Ethereal-Space-Inc/esi-c3-hardware/README.md

This company is crazy but so am I... a match made in heaven.
- jt
