Ethereal-Space-Inc/esi-c3-hardware/esi-c3-hardware/esi-c3-hardware.pdf

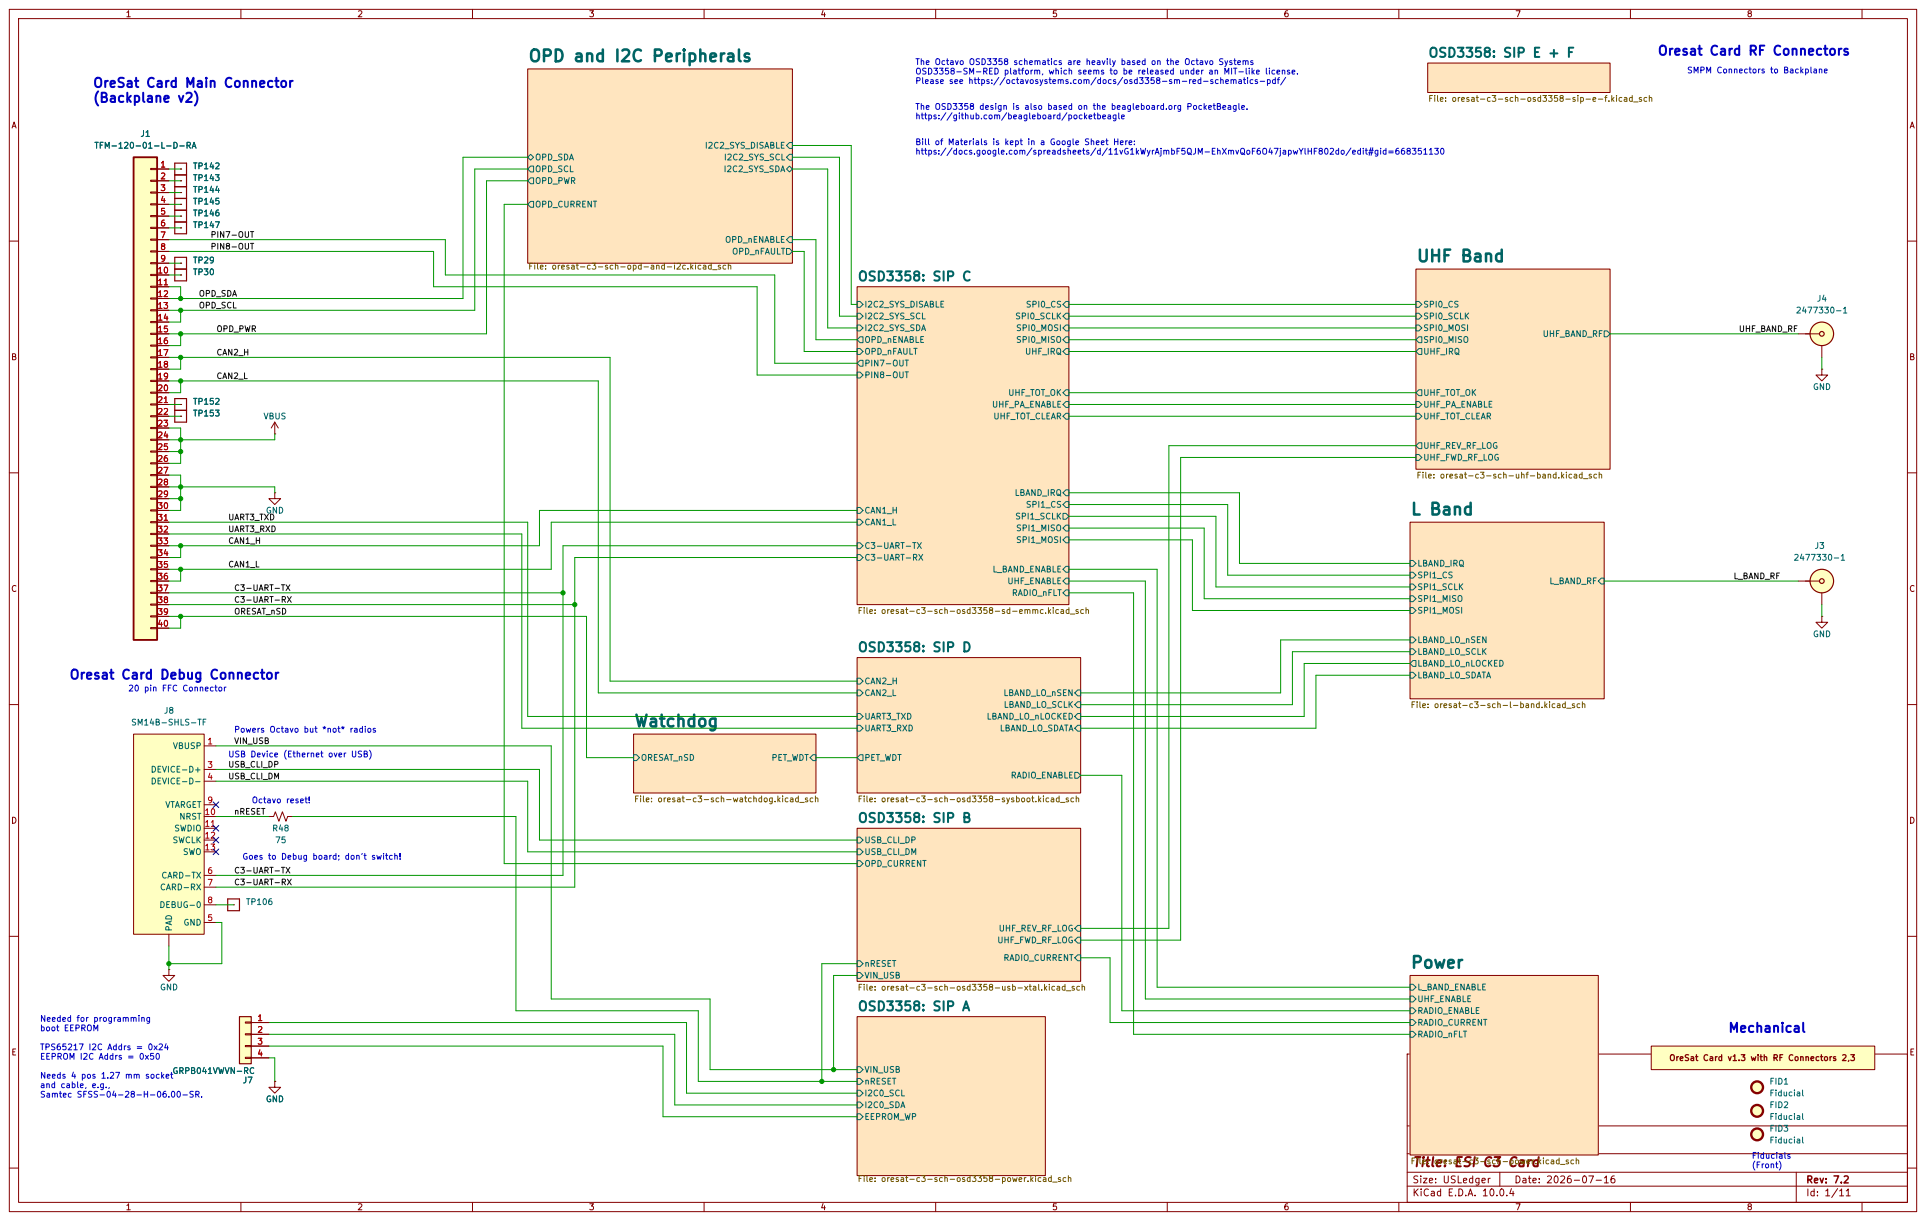
[picture p1: page 1]

Oresat Card RF Connectors

The Octavo OSD3358 schematics are heavily based on the Octavo Systems OSD3358-SM-RED platform, which seems to be released under an MIT-like license. Please see https://octavosystems.com/docs/osd3358-sm-red-schematics-pdf/

SMPM Connectors to Backplane

OreSat Card Main Connector
(Backplane v2)
CAN2_L C3-UART-RX Goes to Debug board; don't switch!

File: oresat-c3-sch-osd3358-sip-e-f.kicad_sch CAN2_H

The OSD3358 design is also based on the beagleboard.org PocketBeagle.
https://github.com/beagleboard/pocketbeagle

Bill of Materials is kept in a Google Sheet Here: https://docs.google.com/spreadsheets/d/11vG1kWyrAjmbF5QJM-EhXmvQoF6O47japwYlHF802do/edit#gid=668351130

File: oresat-c3-sch-uhf-band.kicad_sch OPD_nFAULT

33 33 CAN1_H
34 34

C3-UART-TX ORESAT_nSD 38 38

39 39
40 40

Octavo reset! Oresat Card Debug Connector

USB Device (Ethernet over USB) Powers Octavo but *not* radios

File: oresat-c3-sch-osd3358-sysboot.kicad_sch
nRESET OSD3358: SIP B
VIN_USB USB_CLI_DP

C3-UART-RX C3-UART-TX

Ethereal Space Inc. X PSAS | Mechanical Fiducials

TPS65217 I2C Addrs = 0x24
EEPROM I2C Addrs = 0x50 Needs 4 pos 1.27 mm socket and cable, e.g., Samtec SFSS-04-28-H-06.00-SR.

Fiducial OreSat Card v1.3 with RF Connectors 2,3

Sheet: / File: esi-c3-hardware.kicad_sch | FID3 Fiducial

Size: USLedger | Rev: 7.2
KiCad E.D.A. 10.0.4 | Id: 1/11

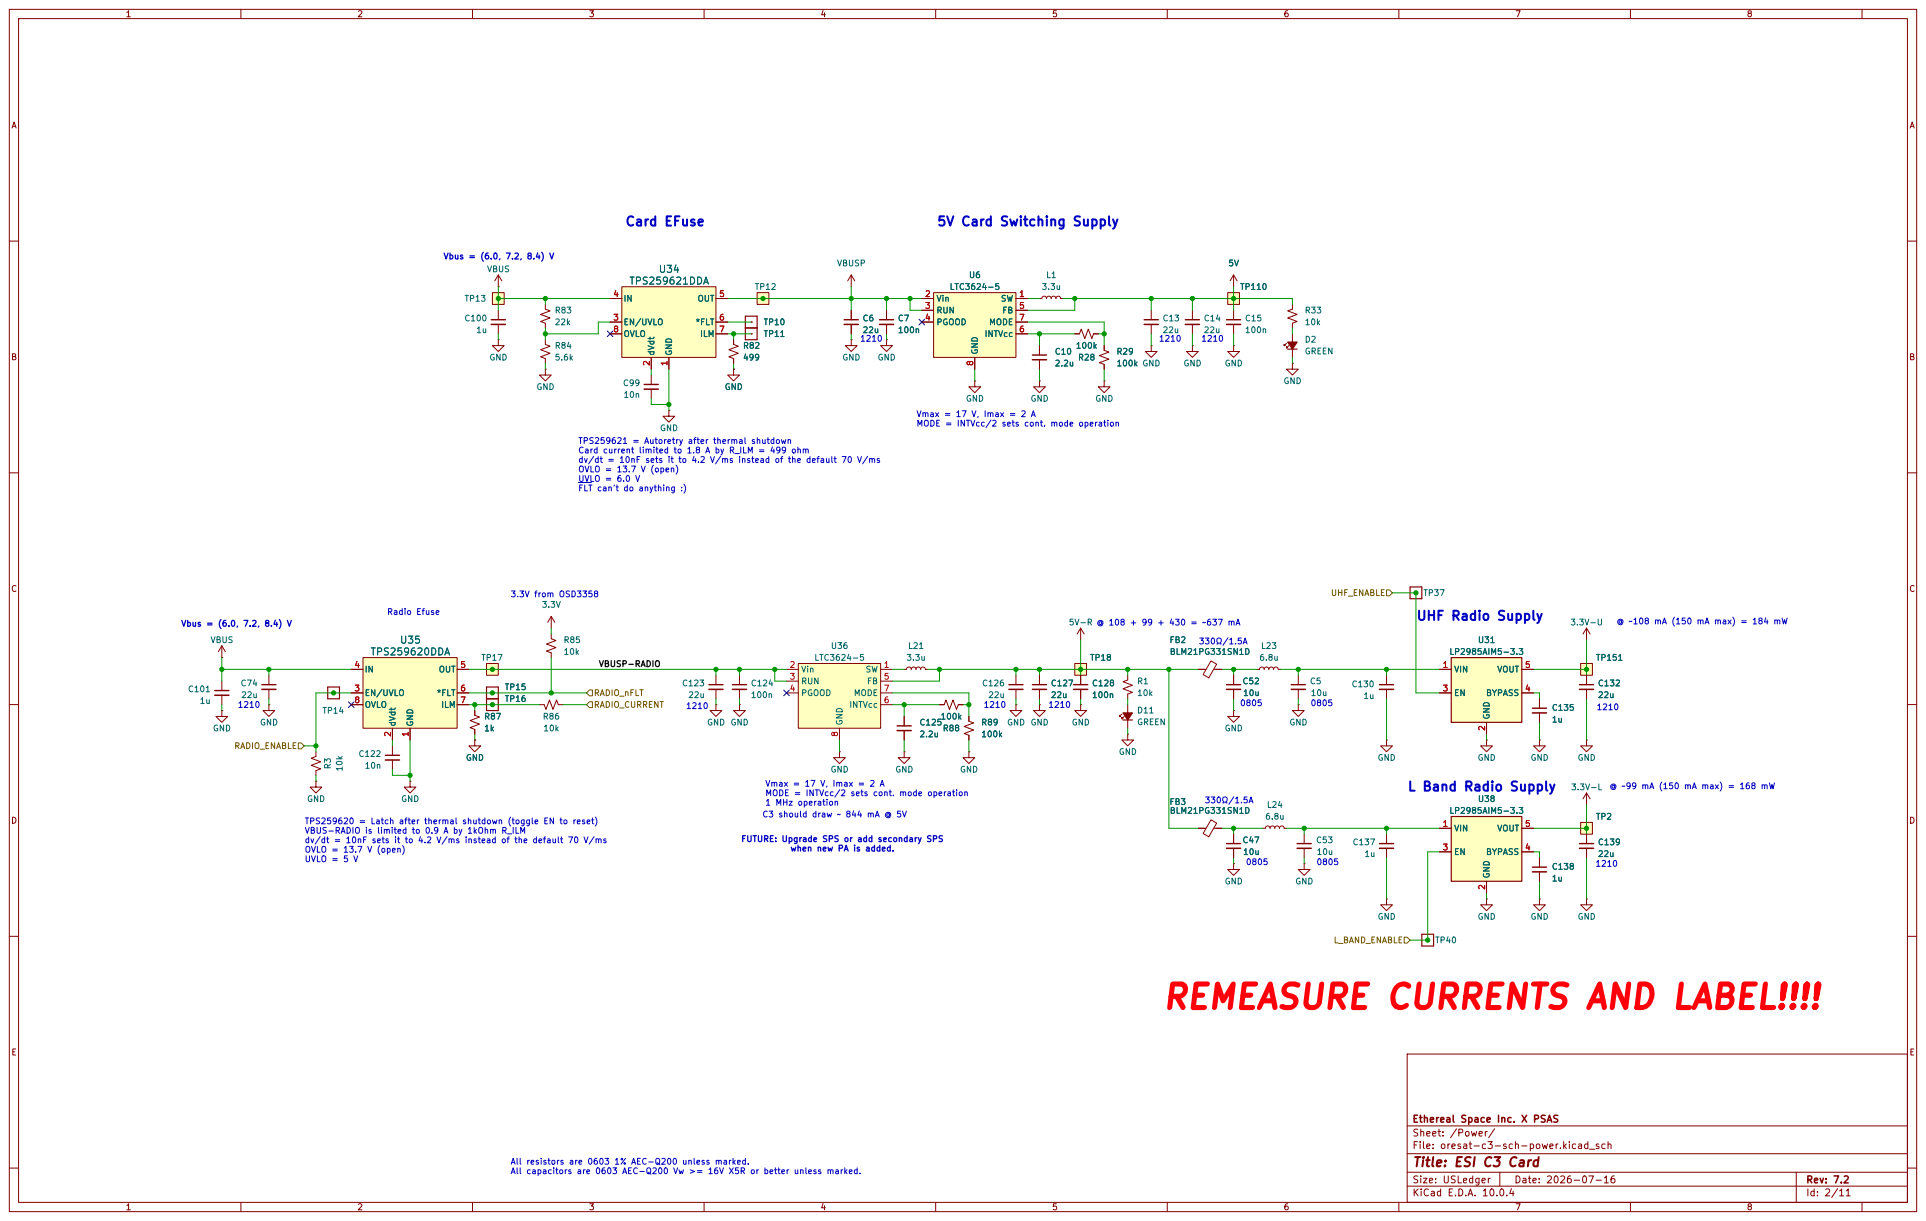
[picture p2: page 2]

TPS259621 = Autoretry after thermal shutdown Card current limited to 1.8 A by R_ILM = 499 ohm

dv/dt = 10nF sets it to 4.2 V/ms instead of the default 70 V/ms OVLO = 13.7 V (open) UVLO = 6.0 V

Vmax = 17 V, Imax = 2 A MODE = INTVcc/2 sets cont. mode operation 1 MHz operation

TPS259620 = Latch after thermal shutdown (toggle EN to reset) VBUS-RADIO is limited to 0.9 A by 1kOhm R_ILM

FUTURE: Upgrade SPS or add secondary SPS when new PA is added. C3 should draw ~ 844 mA @ 5V

Ethereal Space Inc. X PSAS
Sheet: /Power/
File: oresat-c3-sch-power.kicad_sch

All resistors are 0603 1% AEC-Q200 unless marked. All capacitors are 0603 AEC-Q200 Vw >= 16V X5R or better unless marked.

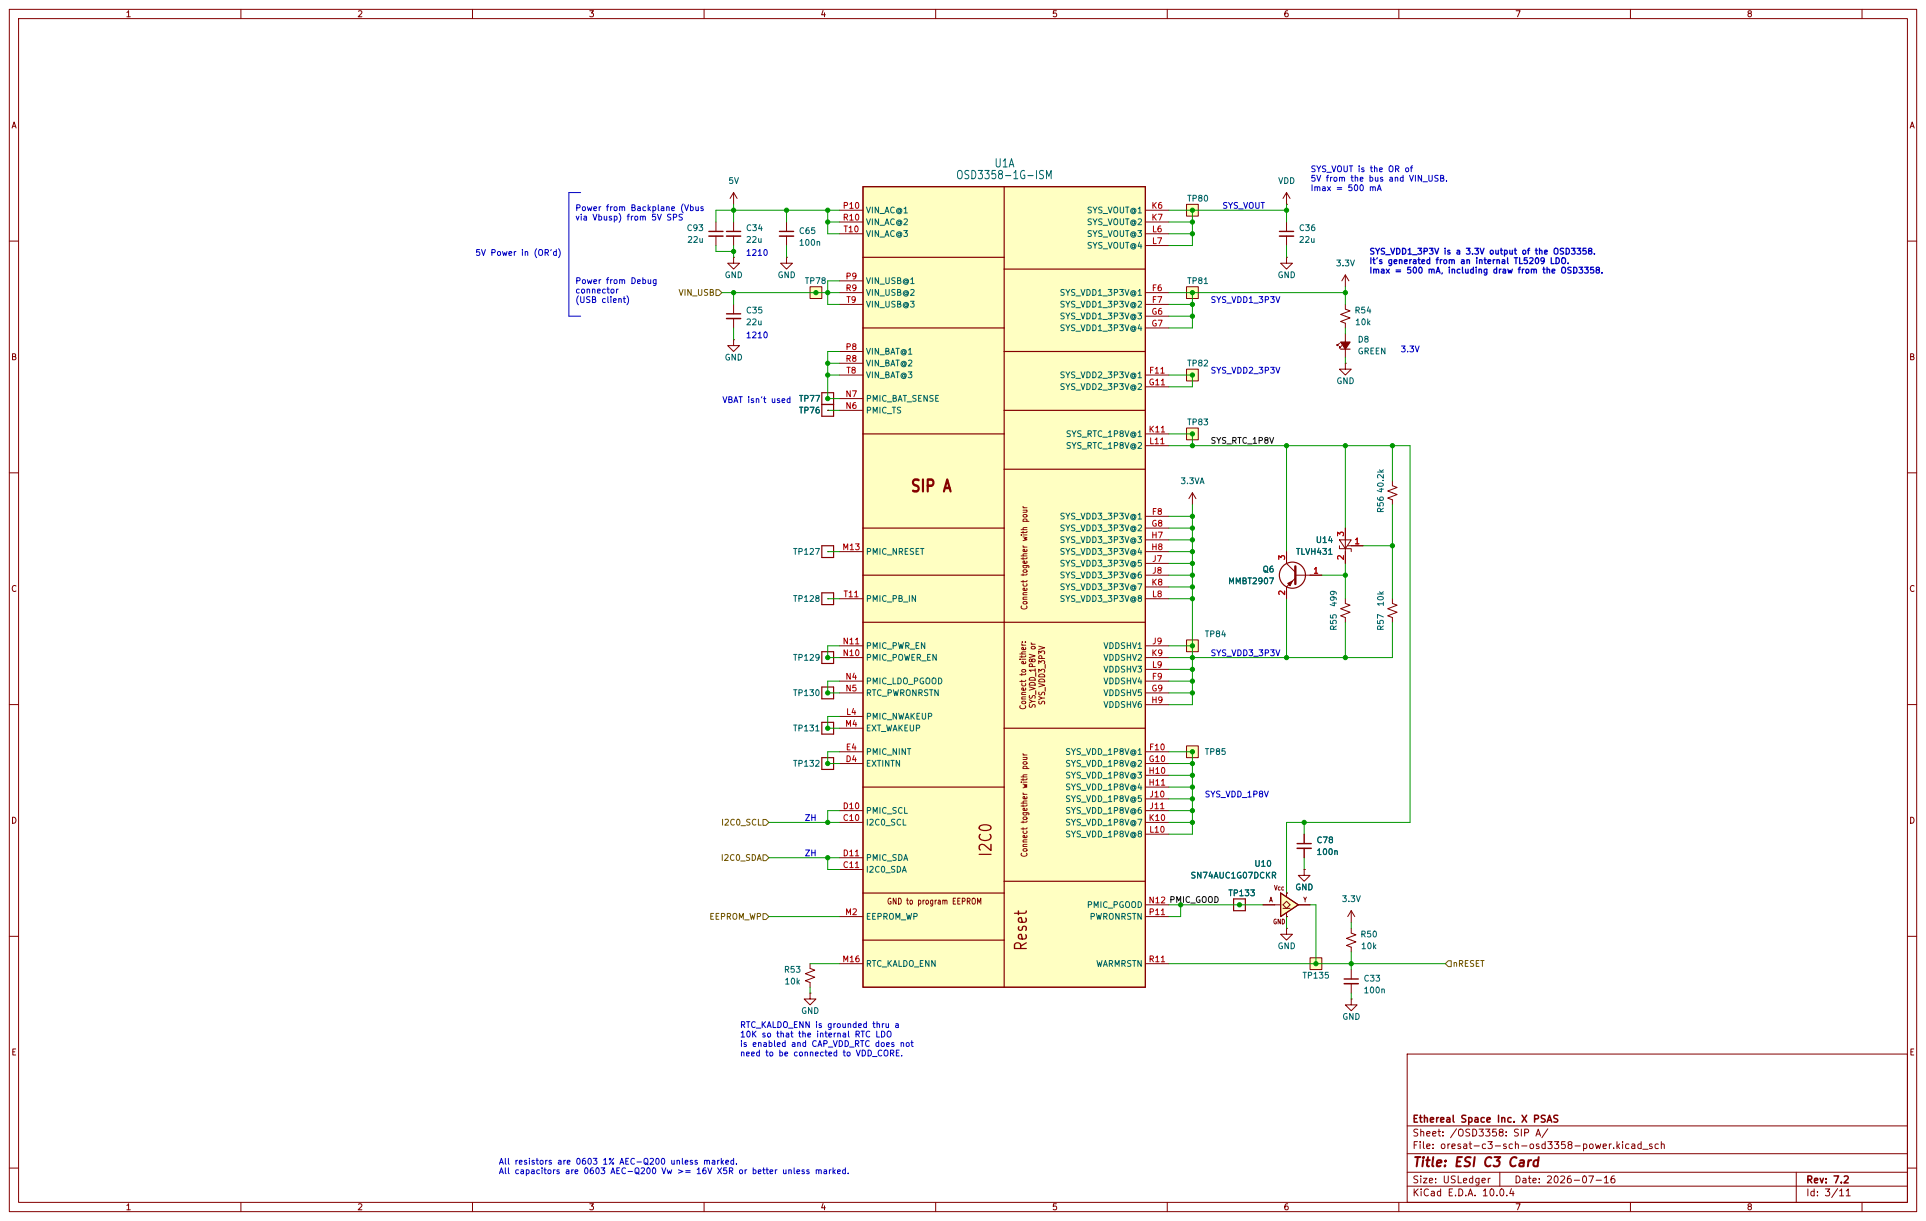
[picture p3: page 3]

VBAT isn't used Power from Backplane (Vbus
via Vbusp) from 5V SPS

SYS_VDD1_3P3V is a 3.3V output of the OSD3358.
It's generated from an internal TL5209 LDO.

Imax = 500 mA, including draw from the OSD3358. 3.3V SYS_VDD1_3P3V ZH

RTC_KALDO_ENN is grounded thru a 10K so that the internal RTC LDO

is enabled and CAP_VDD_RTC does not need to be connected to VDD_CORE. All resistors are 0603 1% AEC-Q200 unless marked. All capacitors are 0603 AEC-Q200 Vw >= 16V X5R or better unless marked.

Ethereal Space Inc. X PSAS
Sheet: /OSD3358: SIP A/
File: oresat-c3-sch-osd3358-power.kicad_sch

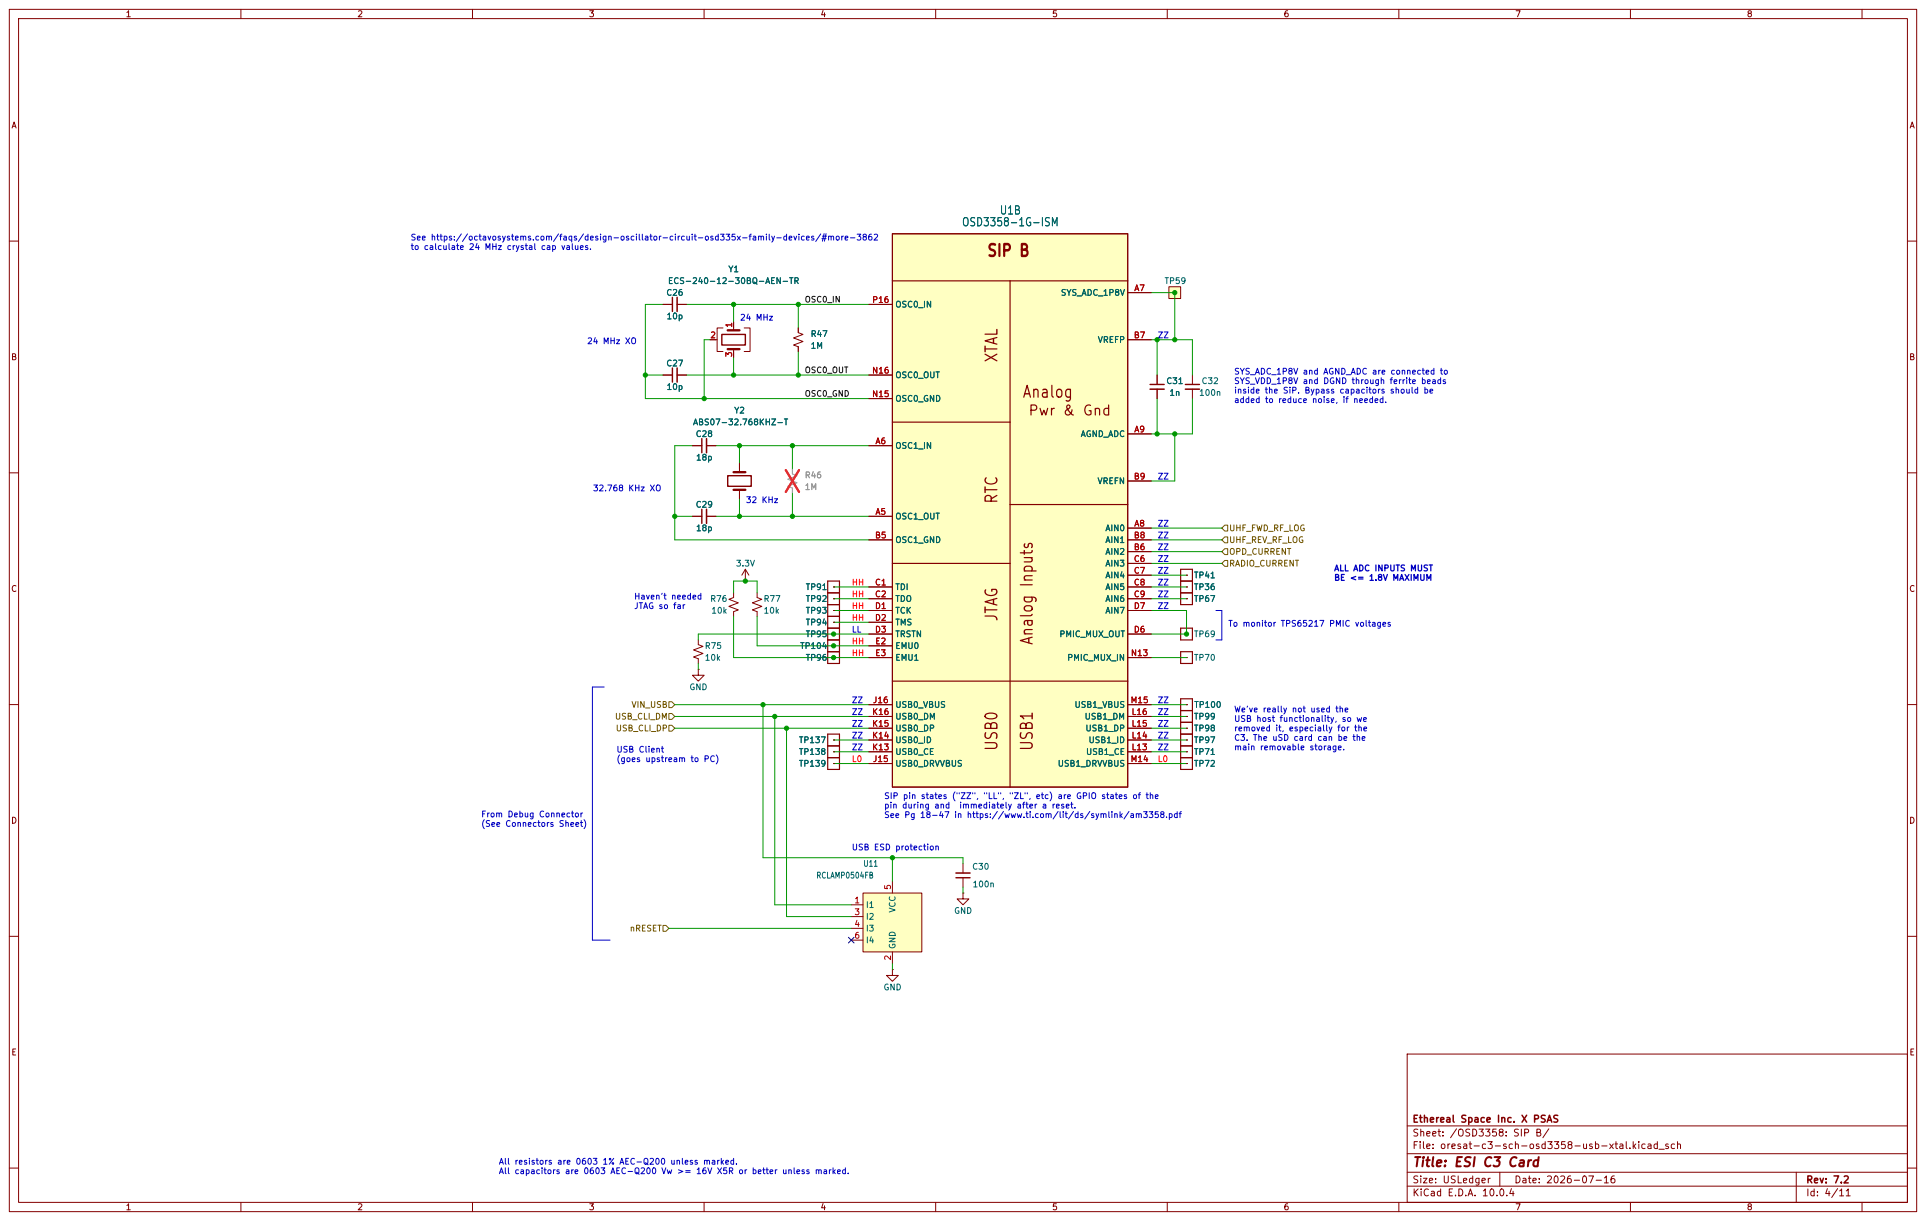
[picture p4: page 4]

SIP B XTAL RTC JTAG USB0

See https://octavosystems.com/faqs/design-oscillator-circuit-osd335x-family-devices/#more-3862

inside the SiP. Bypass capacitors should be added to reduce noise, if needed. 32.768 KHz XO

Pwr & Gnd

SIP pin states ("ZZ", "LL", "ZL", etc) are GPIO states of the pin during and immediately after a reset. See Pg 18-47 in https://www.ti.com/lit/ds/symlink/am3358.pdf ZZ Haven't needed
RADIO_CURRENT VIN_USB

TP95 | HH | EMU0 E2

removed it, especially for the C3. The uSD card can be the main removable storage. ZZ

Ethereal Space Inc. X PSAS
Sheet: /OSD3358: SIP B/
File: oresat-c3-sch-osd3358-usb-xtal.kicad_sch

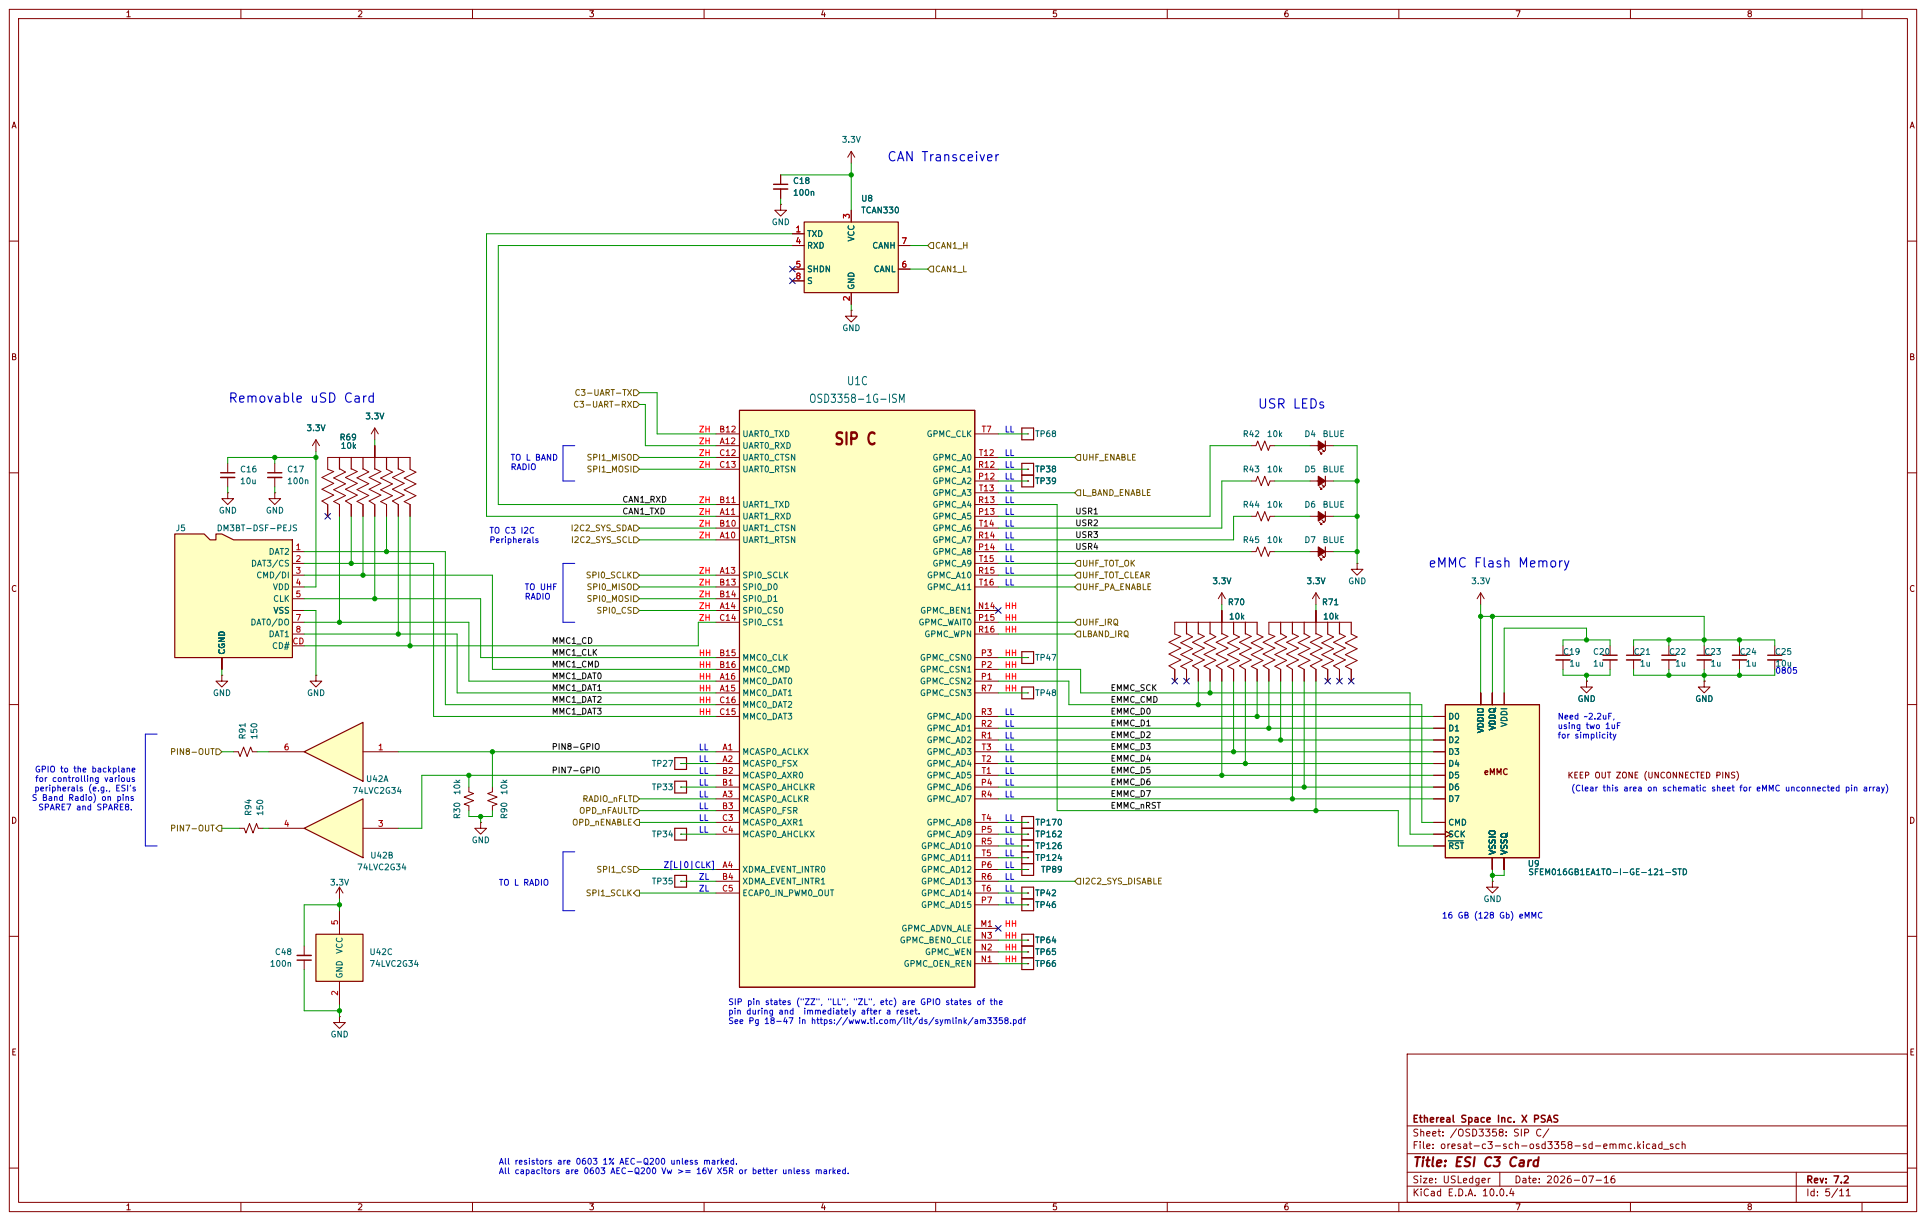
[picture p5: page 5]

ZH TO UHF RADIO

SPI0_D1 B14 MMC0_CLK B15 MMC0_CMD B16 MCASP0_AXR1 C3 MCASP0_AHCLKX C4 SPI0_CS0 A14 MMC0_DAT1 A15 MMC0_DAT0 A16 MCASP0_AHCLKR B1 MCASP0_AXR0 B2 MCASP0_FSR B3 | HH

VSS DAT0/DO 7 DAT1 8 CD# CD CGND
10k GND

LL

LL | | LL | EMMC_D4 | | | | for simplicity LL

EMMC_D3

ZL GPIO to the backplane

ECAP0_IN_PWM0_OUT C5 | | EMMC_D6

LL | EMMC_D7

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

Ethereal Space Inc. X PSAS
Sheet: /OSD3358: SIP C/
File: oresat-c3-sch-osd3358-sd-emmc.kicad_sch

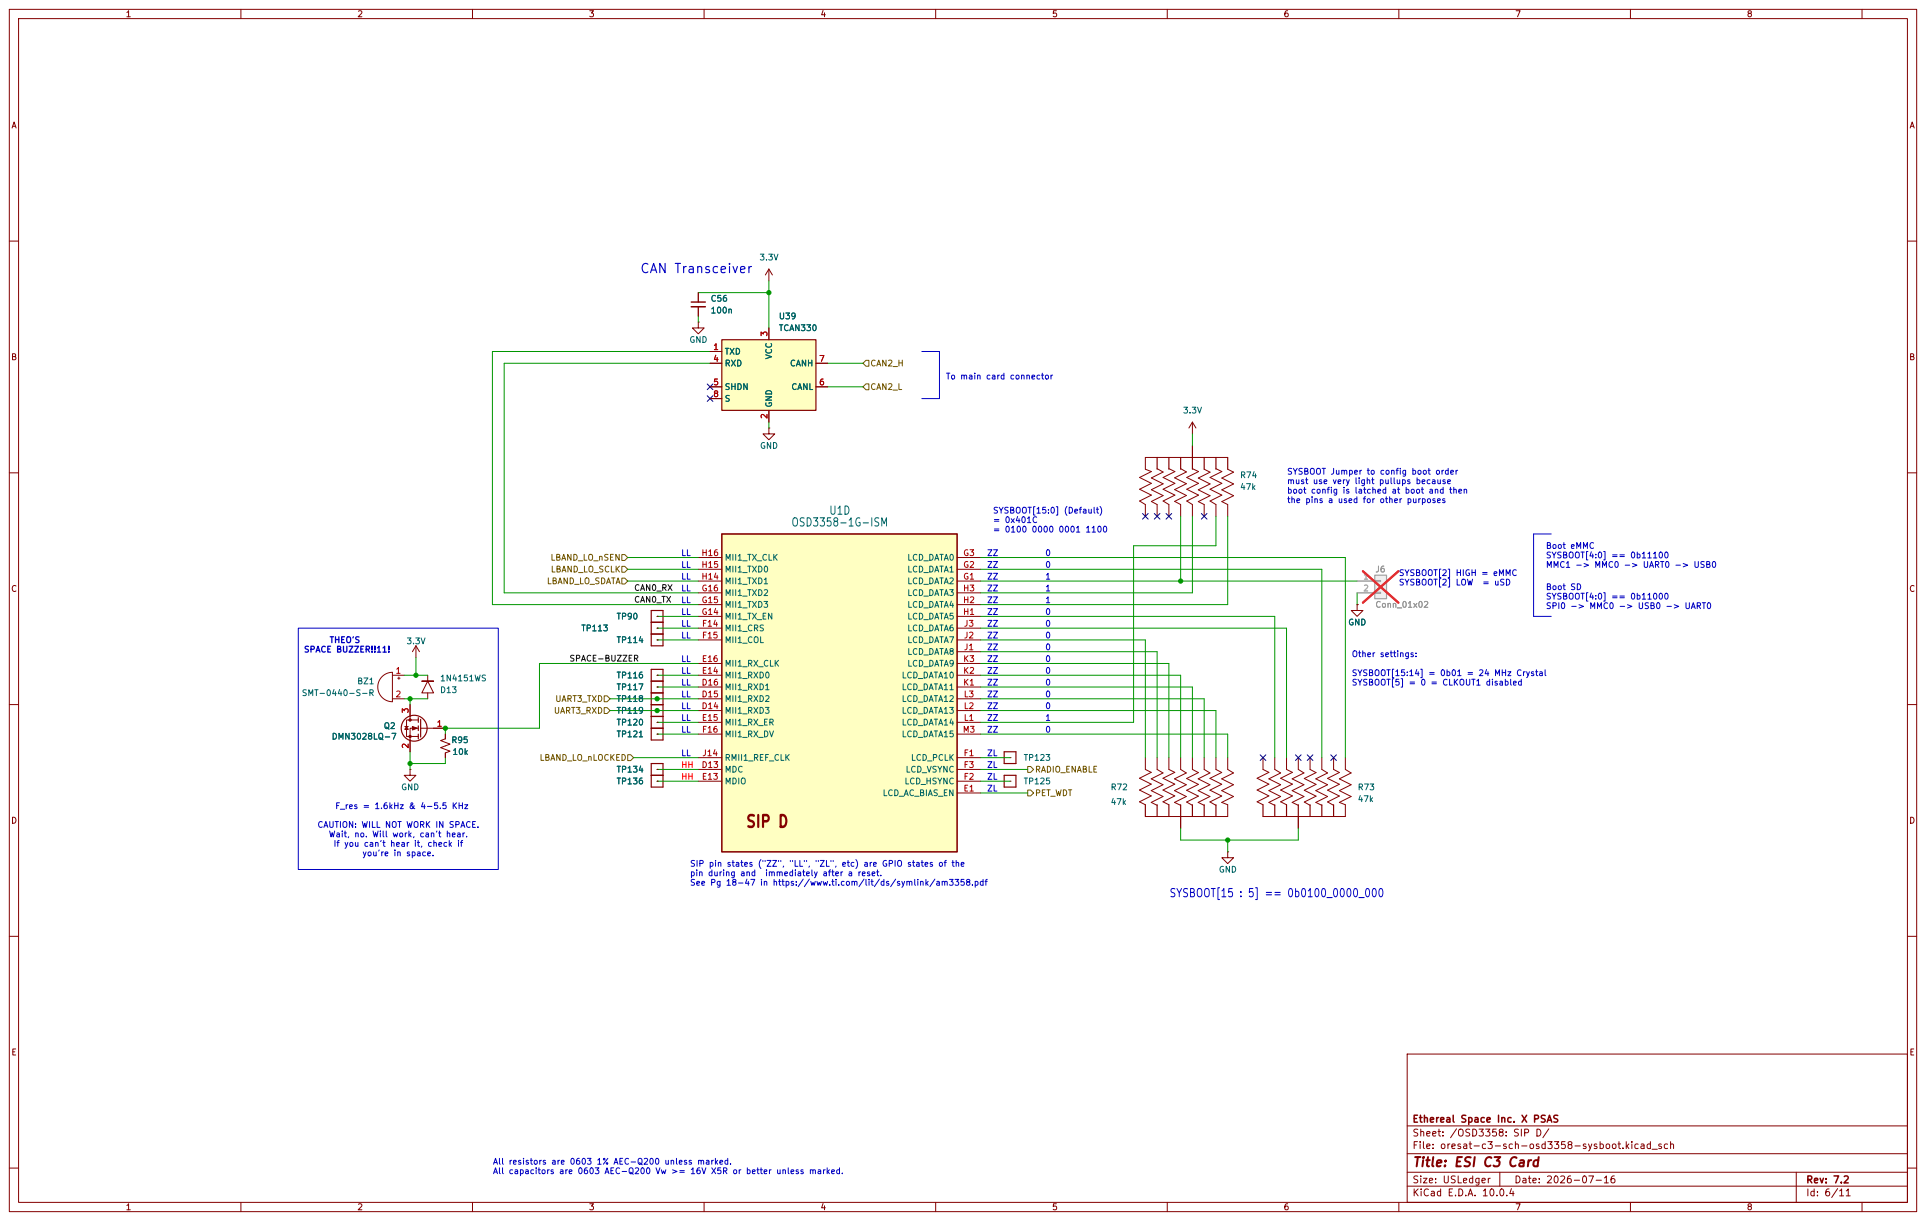
[picture p6: page 6]

47k GND

SYSBOOT Jumper to config boot order must use very light pullups because boot config is latched at boot and then

the pins a used for other purposes Other settings:

ZZ 0 | SYSBOOT[5] = 0 = CLKOUT1 disabled 0

LLSIP pin states ("ZZ", "LL", "ZL", etc) are GPIO states of the pin during and immediately after a reset. See Pg 18-47 in https://www.ti.com/lit/ds/symlink/am3358.pdf All resistors are 0603 1% AEC-Q200 unless marked. All capacitors are 0603 AEC-Q200 Vw >= 16V X5R or better unless marked. HH

ZZ 0
ZZ

F_res = 1.6kHz & 4-5.5 KHz CAUTION: WILL NOT WORK IN SPACE. Wait, no. Will work, can't hear.

Ethereal Space Inc. X PSAS
Sheet: /OSD3358: SIP D/
File: oresat-c3-sch-osd3358-sysboot.kicad_sch

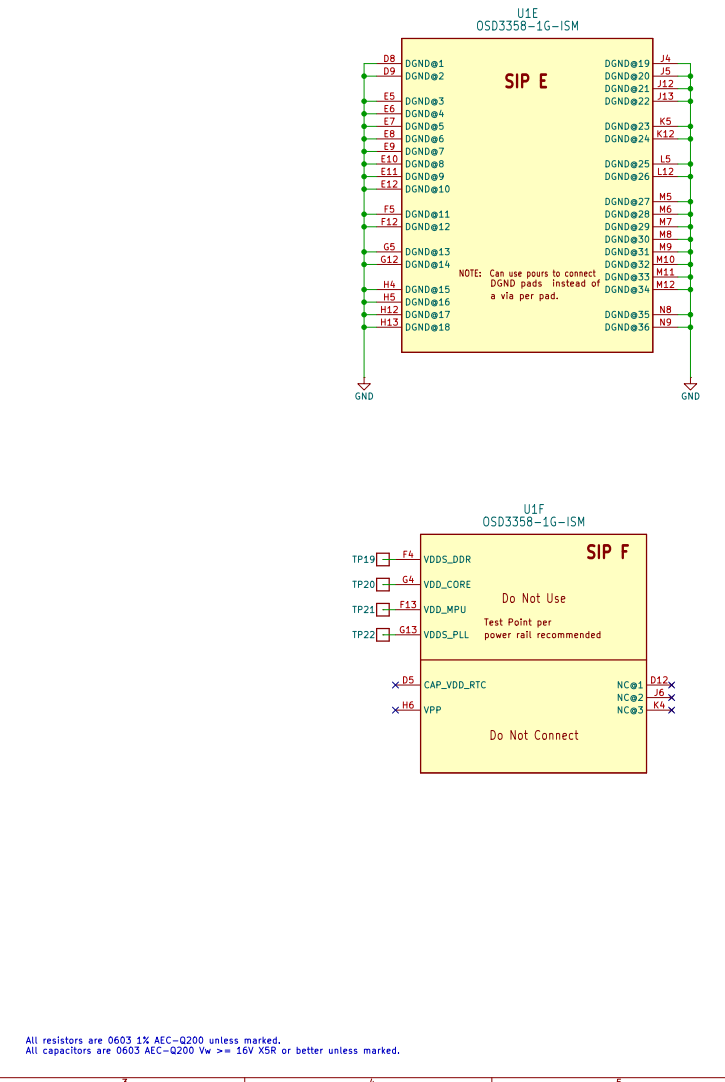
[picture p7: page 7]

Test Point per power rail recommended Do Not Use

Ethereal Space Inc. X PSAS
Sheet: /OSD3358: SIP E + F/
File: oresat-c3-sch-osd3358-sip-e-f.kicad_sch

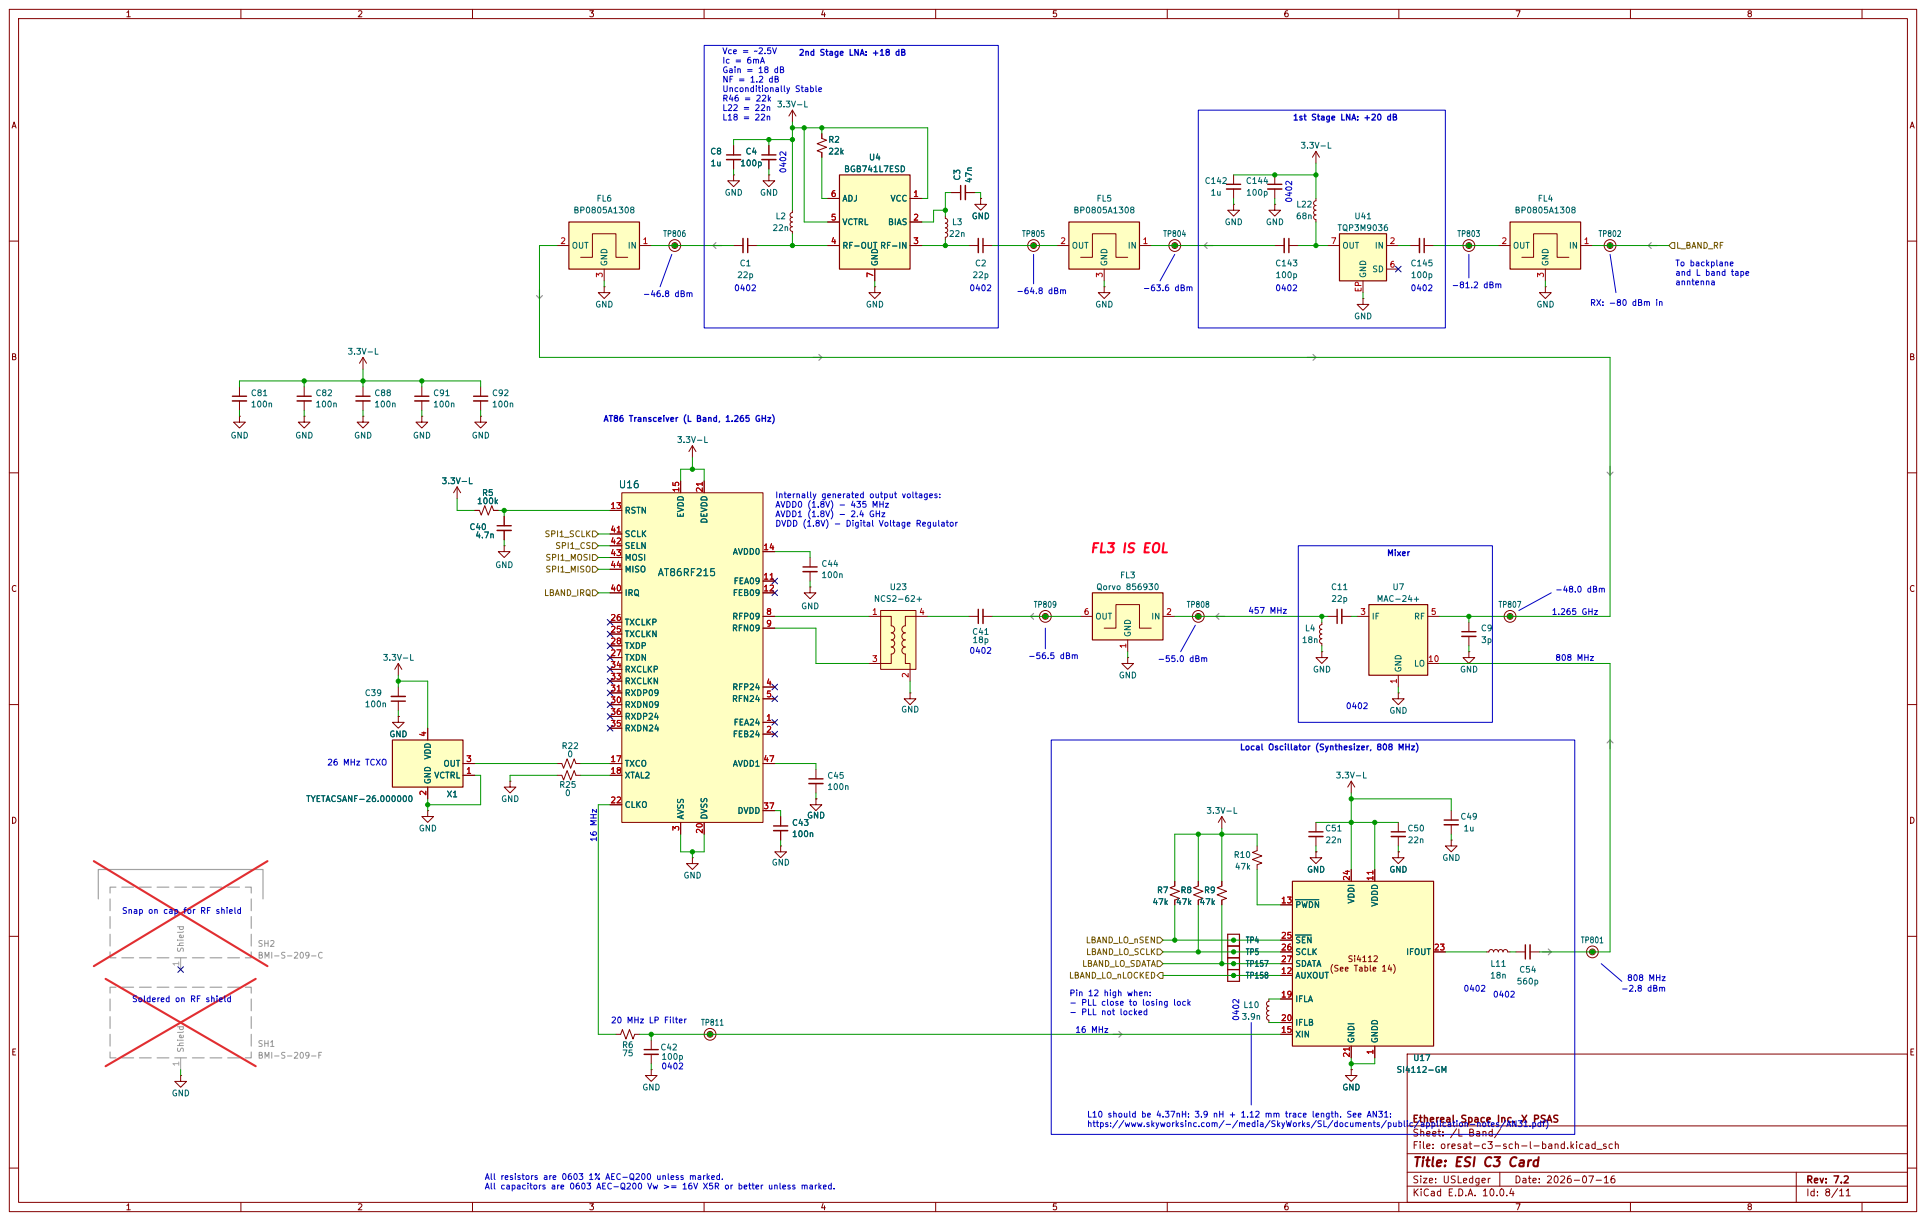
[picture p8: page 8]

Vce = ~2.5V
Ic = 6mA Gain = 18 dB NF = 1.2 dB Unconditionally Stable R46 = 22k
FL5 BP0805A1308 GND GND

To backplane and L band tape anntenna

Local Oscillator (Synthesizer, 808 MHz) L10 should be 4.37nH: 3.9 nH + 1.12 mm trace length. See AN31: https://www.skyworksinc.com/-/media/SkyWorks/SL/documents/public/application-notes/AN31.pdf) 20 MHz LP Filter
TXCO 17

Ethereal Space Inc. X PSAS
Sheet: /L Band/
File: oresat-c3-sch-l-band.kicad_sch

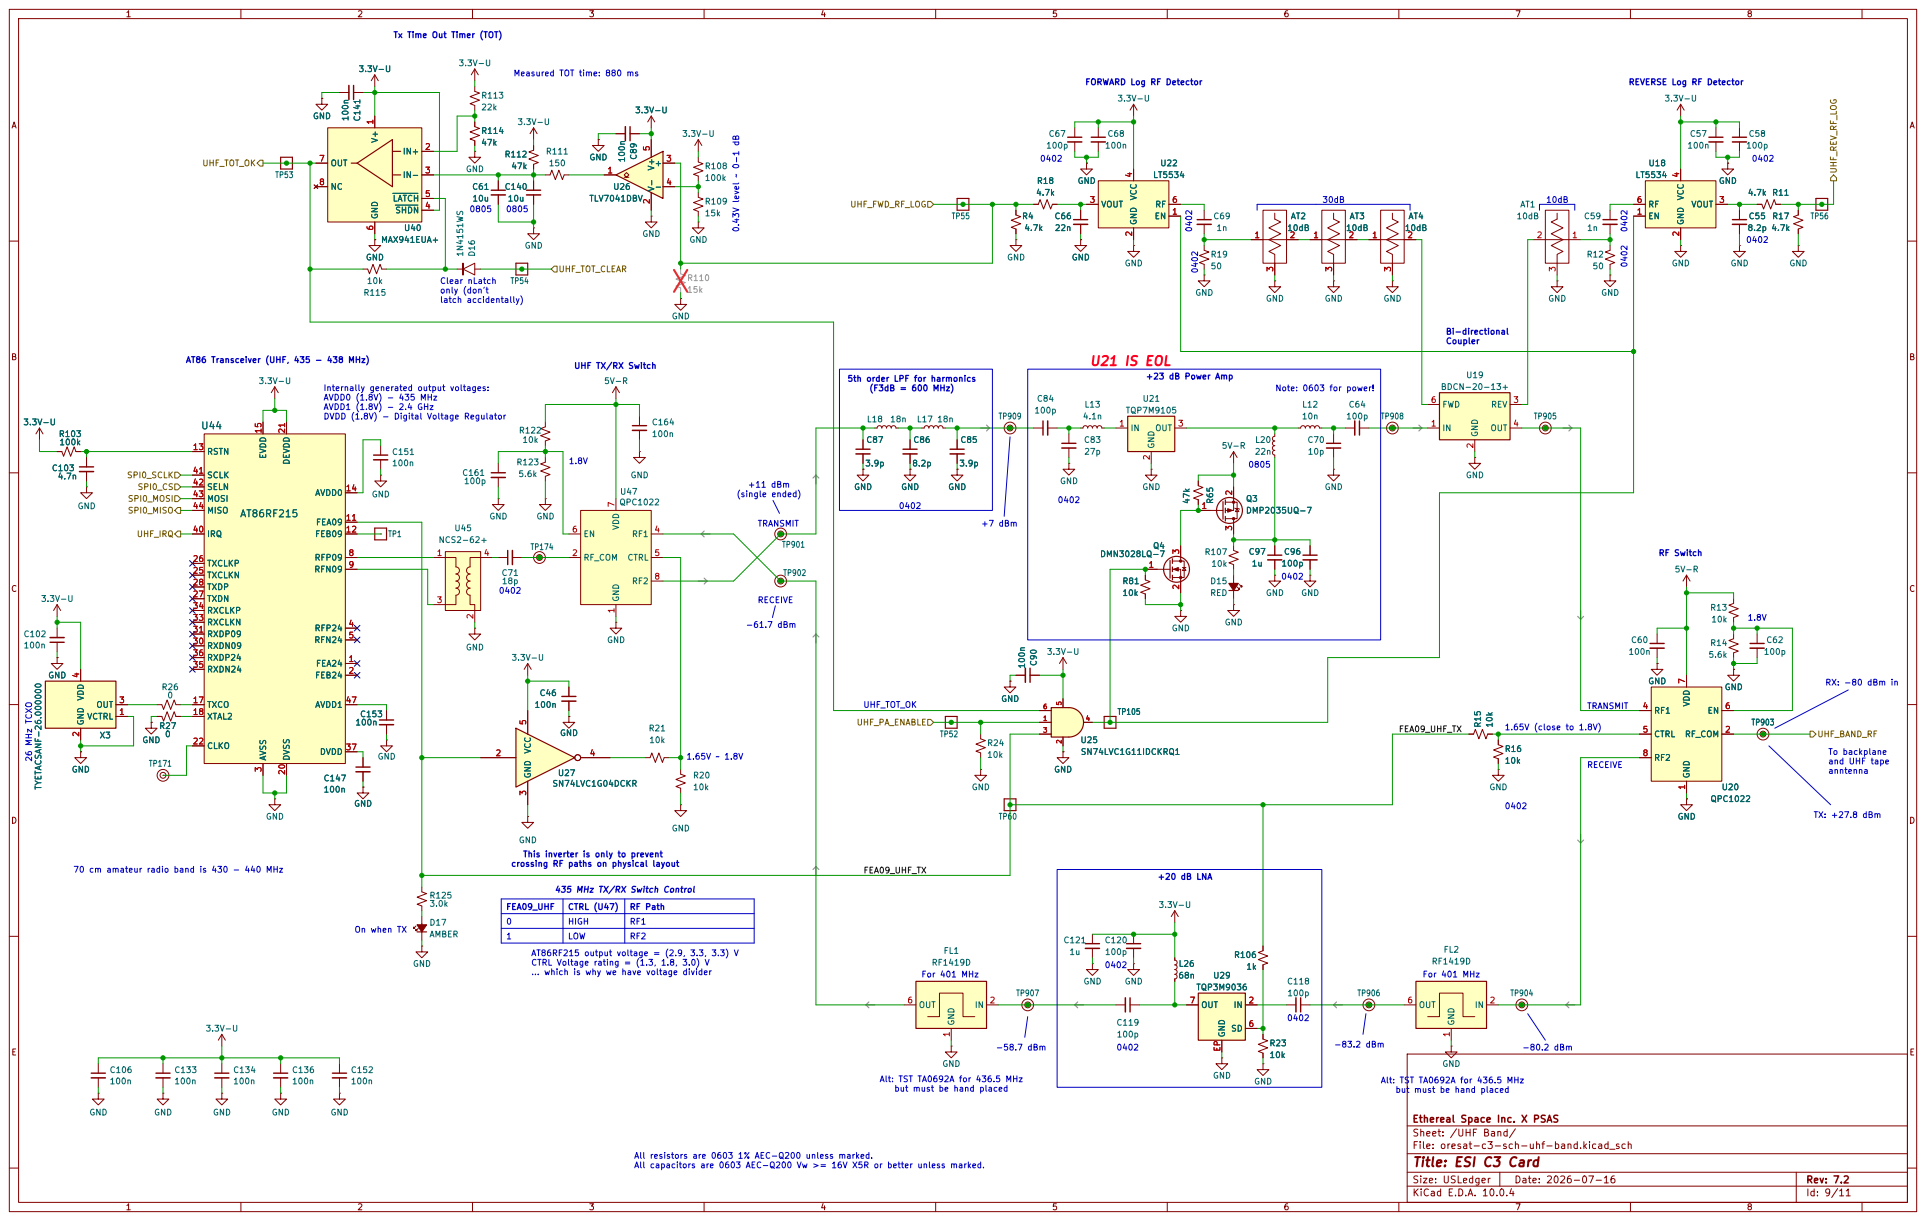
[picture p9: page 9]

FORWARD Log RF Detector

REVERSE Log RF Detector

To backplane and UHF tape anntenna RX: -80 dBm in

This inverter is only to prevent

Alt: TST TA0692A for 436.5 MHz but must be hand placed 70 cm amateur radio band is 430 - 440 MHz

435 MHz TX/RX Switch Control

FEA09_UHF | CTRL (U47) HIGH | RF Path 0 RF1

1 | LOW | RF2

AT86RF215 output voltage = (2.9, 3.3, 3.3) V CTRL Voltage rating = (1.3, 1.8, 3.0) V

... which is why we have voltage divider

For 401 MHz All resistors are 0603 1% AEC-Q200 unless marked. All capacitors are 0603 AEC-Q200 Vw >= 16V X5R or better unless marked.

Ethereal Space Inc. X PSAS
Sheet: /UHF Band/
File: oresat-c3-sch-uhf-band.kicad_sch

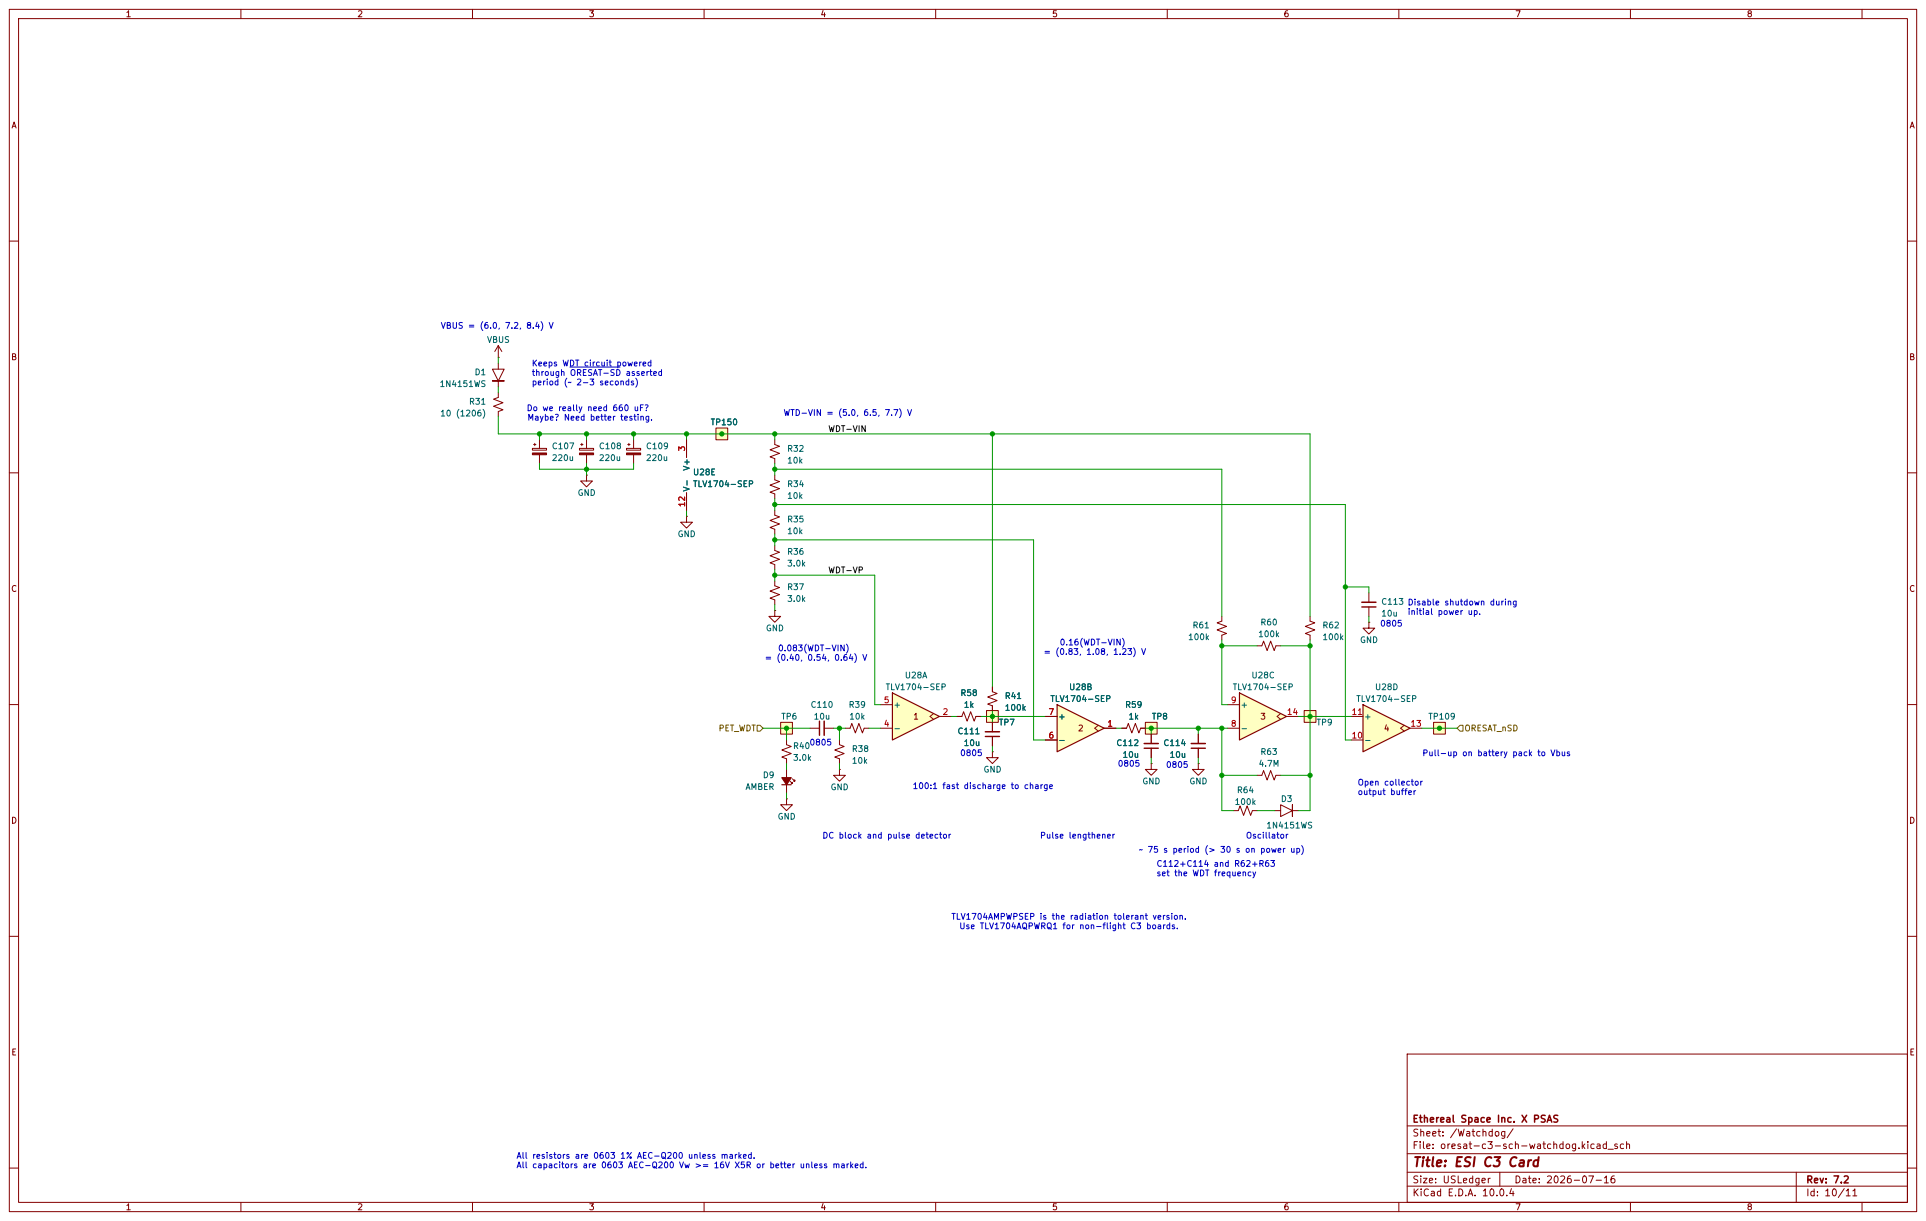
[picture p10: page 10]

0805 Keeps WDT circuit powered
through ORESAT-SD asserted
period (~ 2-3 seconds)

WTD-VIN = (5.0, 6.5, 7.7) V 0.083(WDT-VIN) = (0.40, 0.54, 0.64) V

DC block and pulse detector 100:1 fast discharge to charge

Ethereal Space Inc. X PSAS
Sheet: /Watchdog/
File: oresat-c3-sch-watchdog.kicad_sch

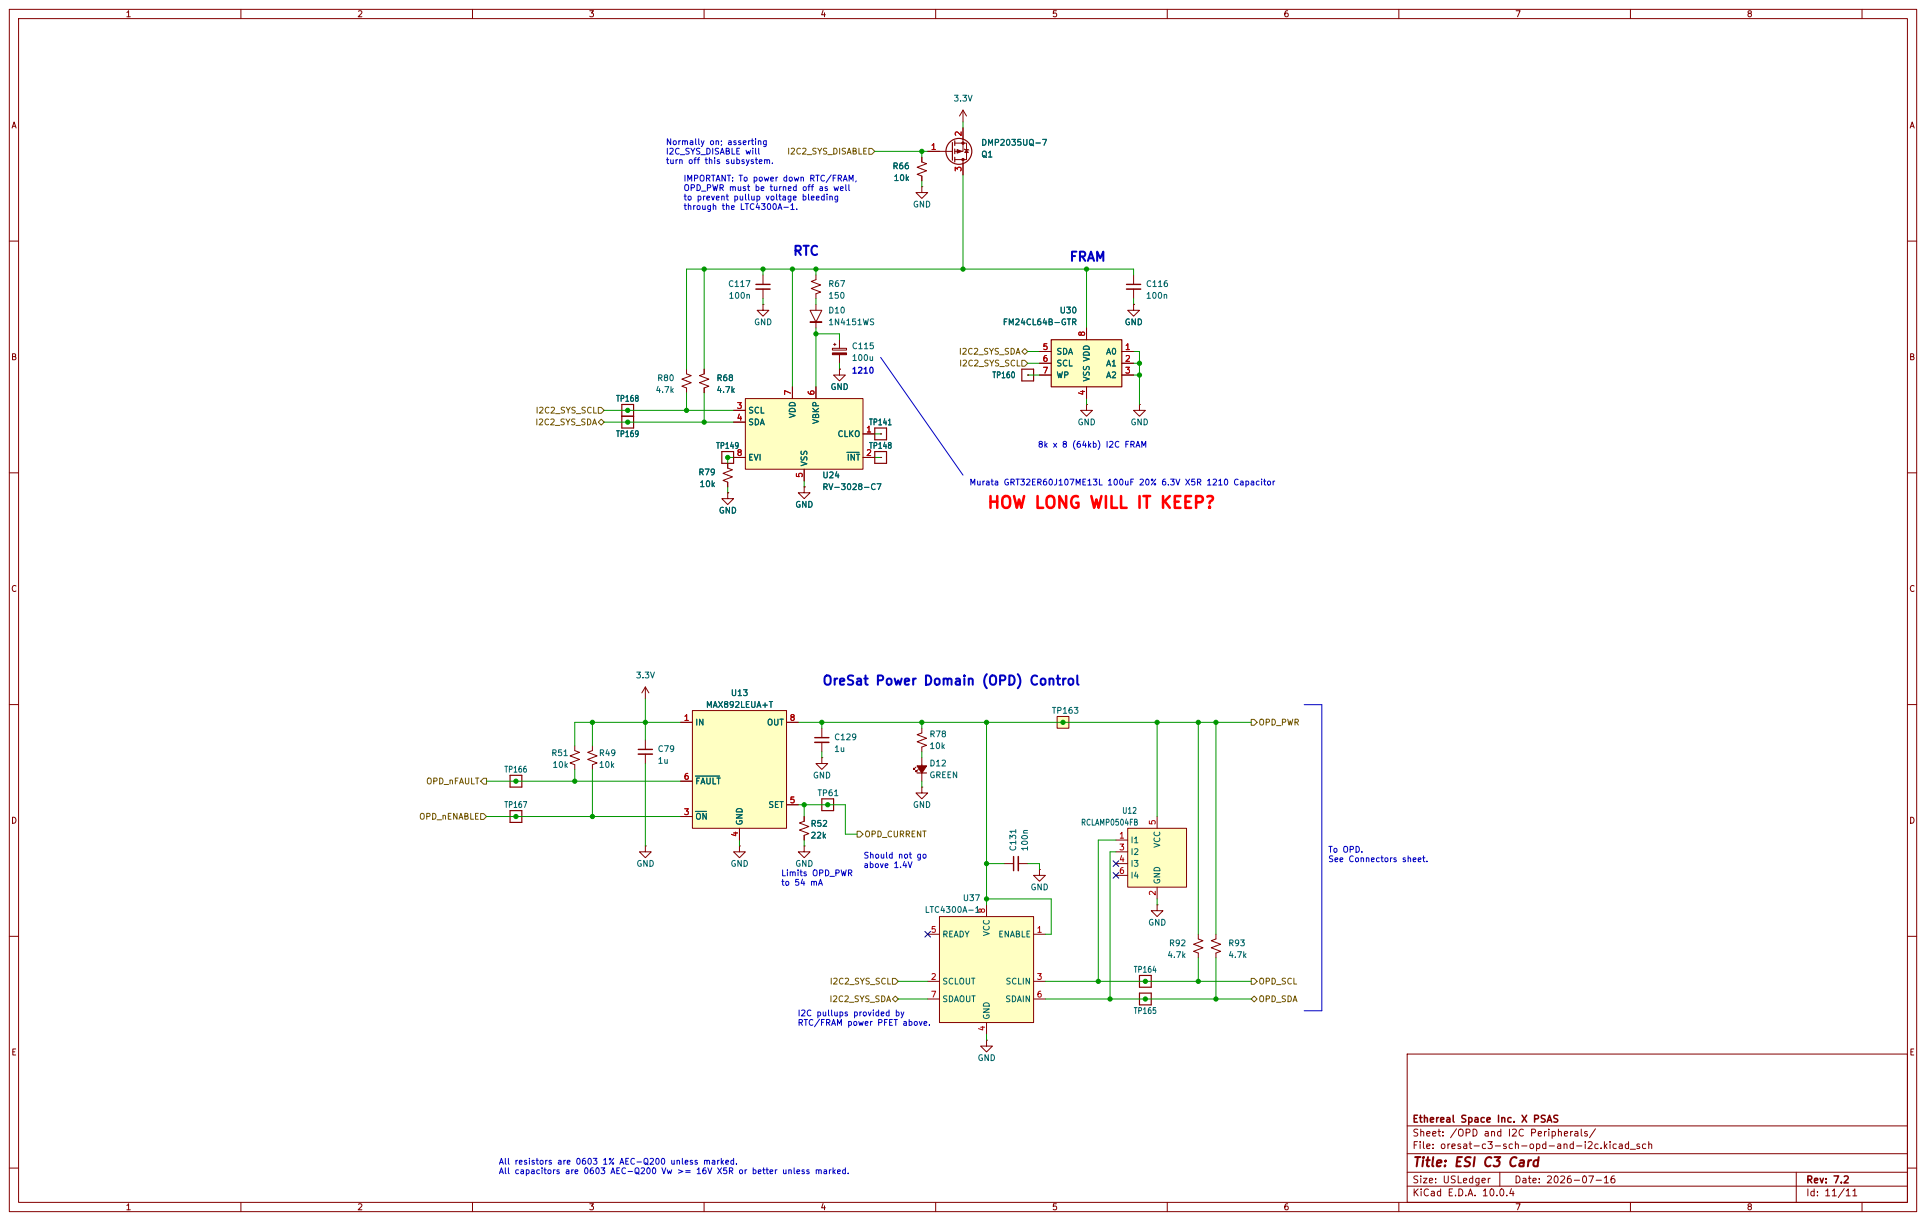
[picture p11: page 11]

Normally on; asserting
I2C_SYS_DISABLE will
turn off this subsystem.

IMPORTANT: To power down RTC/FRAM, OPD_PWR must be turned off as well to prevent pullup voltage bleeding

To OPD. See Connectors sheet. Murata GRT32ER60J107ME13L 100uF 20% 6.3V X5R 1210 Capacitor 8k x 8 (64kb) I2C FRAM HOW LONG WILL IT KEEP?

OreSat Power Domain (OPD) Control

RTC/FRAM power PFET above. All resistors are 0603 1% AEC-Q200 unless marked. All capacitors are 0603 AEC-Q200 Vw >= 16V X5R or better unless marked.

Ethereal Space Inc. X PSAS
Sheet: /OPD and I2C Peripherals/
File: oresat-c3-sch-opd-and-i2c.kicad_sch
